dnviti-personal-org/esp8266-d1mini-button/hardware/enclosure/full-iso-nolid.png

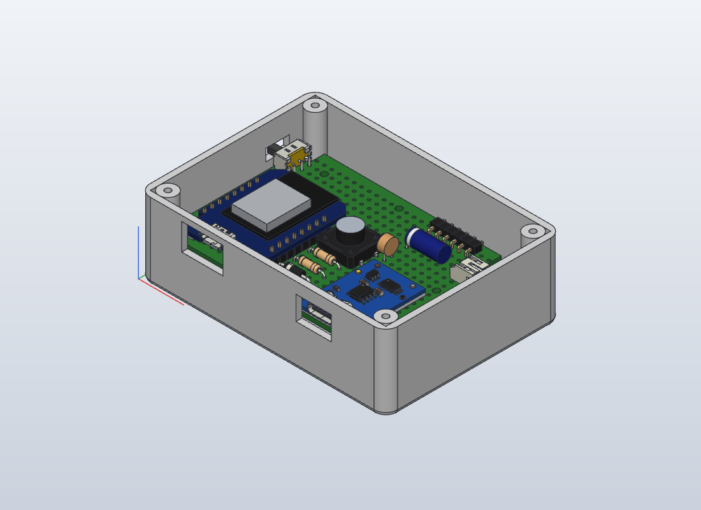
hardware/enclosure/full-iso-nolid.png
