dnviti-personal-org/esp8266-d1mini-button/hardware/enclosure/electronics-iso.png

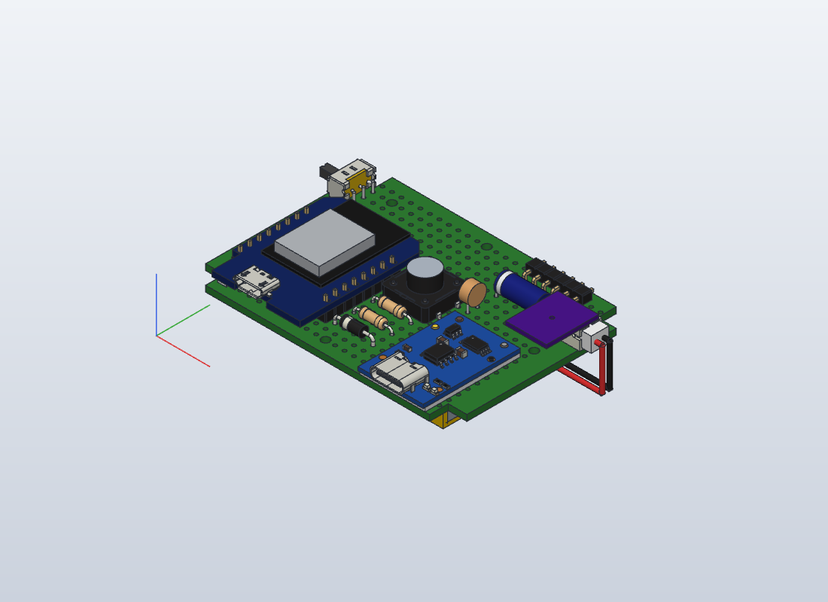
hardware/enclosure/electronics-iso.png
