dnviti-personal-org/esp8266-d1mini-button/hardware/enclosure/README.md

# Enclosure (rev. C, realistic electronics from `layout.json`) — 3D-printed box for the ESP8266 D1 mini button

Parametric CAD built with **SolidCraft** (`solidcraft-cli`) from the JSON scripts
in this folder. Box, lid and key cap follow `../DESIGN.md` §6 (LiPo under the
board, charging USB-C, INMP441 microphone, big domed key cap) except for the
deviations listed below. Since **rev. C** the electronics model is generated
from `../layout/layout.json` (the single source of truth for every lead
position and every wire, produced by `../layout/gen_layout.py`): perfboard at
cavity offset (2.46, 1.73), 5 × 5 notches, mounting holes on grid holes L1,
L18, C17, X11, every lead in its named hole, all 25 solder-side wires
modelled, SW2 on the x = 0 wall, M1 glued flat.

## Files

| File | What it is |
|---|---|
| `base.script.json` → `base.solidcraft`, `base.stl`, `base.step` | Box: 2 mm floor + 2 mm walls around the 80 × 56 × 24 mm cavity, 4 PCB standoffs Ø5 × 11 at cavity (36.19, 5.14) (36.19, 48.32) (13.33, 45.78) (66.67, 30.54) (= perfboard grid holes L1, L18, C17, X11 + offset), 4 lid screw bosses Ø6, programming micro-USB slot 14 × 9 at cavity x 19.68 and charging USB-C slot 12 × 8 at x 57.5, z 16.2 (y = 0 wall; micro-USB z 17.7), slide-switch slot 8 (y) × 4 (z) through the **x = 0 wall** at cavity y 43.24 (hole A16), z 14.75 (= centre of the SW2 knob with the switch body resting on the board top), 4 rubber-foot recesses Ø8 × 0.8. Outer 84 × 60 × 26 mm. |
| `lid.script.json` → `lid.solidcraft`, `lid.stl`, `lid.step` | 84 × 60 × 2 mm plate with the Ø52.6 key-cap hole, 4 countersunk Ø2.8 screw holes, 1 mm alignment lips on the short sides (the right one in two segments), INMP441 microphone pocket 11.5 × 15 × 1.2 mm on the underside with a Ø2 sound hole, and the 10 × 2.5 charge-LED window at cavity (62, 4.5). Bounding box 84 × 60 × 3.5 mm (2 plate + 1.5 lips). |
| `plunger.script.json` → `plunger.solidcraft`, `plunger.stl`, `plunger.step` | Key cap: Ø52 domed cap, Ø55 retaining flange, Ø8 stem. Bounding box Ø55 × 13.8 mm. Unchanged from rev. A. |
| `assembly.script.json` → `assembly.solidcraft` | The three printed parts, exploded by the `explode` parameter (14 mm; 0 = assembled). |
| `electronics.script.json` → `electronics.solidcraft`, `electronics.step` (the .stl is not committed: 16 MB, regenerate with the script) | **Realistic** electronics generated by `gen_electronics.py` from `../layout/layout.json`: real STEP models from `models/` (see `models/SOURCES.md`) inserted with `file.insert_step`, the rest built in the script (perfboard with its 24 × 18 hole grid, notches and mounting holes; TP4056 module foam/PCB/pads; C3, C4; SW2 bent pins; INMP441 breakout; LiPo pouch, kapton band, leads and plug; all wires `W<n>_<net>` and the JP1 bridge `W2_RST`). Bodies are named by reference designator. World = cavity + 2. |
| `full-assembly.script.json` → `full-assembly.solidcraft`, `full-assembly.step` (.stl not committed, 18 MB) | Base + electronics + lid + key cap + M2, assembled (`explode` = 0). |
| `electronics-nobattery.script.json` | `electronics.script.json` with the BT1 bodies removed (for `electronics-bottom.png`). |
| `full-assembly-exploded.script.json`, `full-assembly-nolid.script.json`, `full-assembly-section.script.json`, `full-assembly-check.script.json` | Variants of the full assembly: `explode` = 14; lid/cap/M2 removed (`solid.remove`, used for the "nolid" renders — a `show_lid` parameter is not possible because a SolidCraft parameter cannot drive visibility); everything in front of world y = 29 removed or cut (1 mm beside the key-cap centre, along X — the revolve seam at y = 30 itself cannot be cut) for the section render; `inspect.interference` on all bodies. |
| `base-iso.png`, `base-top.png`, `base-bottom.png`, `lid-iso.png`, `lid-bottom.png`, `lid-underside.png` (mic pocket + lips), `plunger-iso.png`, `assembly-iso.png` | Snapshots of the printed parts. |
| `electronics-iso.png`, `electronics-top.png` (component side, straight down), `electronics-bottom.png` (solder side, looking up, battery hidden so all wires show; `electronics-bottom-with-battery.png` with the LiPo), `full-top-nolid.png`, `full-iso-nolid.png`, `full-iso.png`, `full-exploded.png`, `full-section.png` | Populated board alone; full assembly: top and iso without lid/cap, closed, exploded, and sectioned 1 mm beside the key-cap centre. |
| `models/*.step`, `models/SOURCES.md` | The STEP models used, with their origin and licence (KiCad packages3D CC-BY-SA 4.0 + KiCad library exception; Technariumas shd18badge Apache-2.0). |

The base and lid are modelled with the **outer bottom-left corner at the
origin**; cavity coordinates from DESIGN.md are world coordinates + (2, 2, 2).
The lid's z = 0 is its underside (lips go to negative z). The key cap is
centred on the Z axis with z = 0 at the flange underside.

## Rebuilding

From WSL (Windows paths because the CLI is a Windows executable; copy the
scripts to a Windows folder first):

```
SC="/mnt/c/Program Files/SolidCraft/solidcraft-cli.exe"
WD='C:\Users\<you>\esp-button-cad\enclosure'
"$SC" run "$WD\base.script.json"    --out "$WD\base.stl"    --out "$WD\base.step"    --save "$WD\base.solidcraft"
"$SC" run "$WD\lid.script.json"     --out "$WD\lid.stl"     --out "$WD\lid.step"     --save "$WD\lid.solidcraft"
"$SC" run "$WD\plunger.script.json" --out "$WD\plunger.stl" --out "$WD\plunger.step" --save "$WD\plunger.solidcraft"
"$SC" run "$WD\assembly.script.json" --save "$WD\assembly.solidcraft"
"$SC" snapshot "$WD\base.script.json" --out "$WD\base-iso.png" --view iso --width 1000 --height 750 --no-grid
"$SC" snapshot "$WD\lid.script.json"  --out "$WD\lid-underside.png" --camera '{"target":[42,30,0],"yaw":0.6,"pitch":-0.9,"distance":230}' --no-grid
```

`electronics.script.json` and the `full-assembly*.script.json` variants are
written by `gen_electronics.py` (run it in the staging folder that holds
`lid/base/plunger.script.json`, with the path of `../layout/layout.json` as its
argument; it expects the STEP models at `C:/Users/daniele/esp-button-cad/models/`
— edit `M` at the top for another machine). Do not edit those scripts by hand.

`solidcraft-cli eval <script>` prints bounding box, volume and mass of each body.
`assembly.script.json` is the lid script, then the base parameters, the lid
move, the key-cap script, the cap move, and finally the base script
(parameters deduplicated by name); regenerate it the same way after editing a
part script.

### Parameters

`base.script.json` and `lid.script.json` start with `parameters.add` commands
(`wall`, `floor_t`, `cav_x/y/z`, `r_vert`, `r_edge`, `boss_d`, `standoff_d/h`,
`usb_*` (programming), `usbc_*` (charging), `sw_*`, `foot_*`, `lip_*`,
`cap_hole_d`, `cap_x/y`, `mic_x/y`, `mic_hole_d`, `mic_pocket_w/l/d`, `led_*`). All box/cylinder sizes and
positions are expressions of these. Limitation of the SolidCraft script
format: fillet edge picks and `solid.hole` positions are numeric 3D points
(boss/standoff/mic centres on the top faces), so after changing `cav_x`,
`cav_y`, `cav_z`, `wall`, `standoff_h` or `mic_x/y` also update those points.
The key cap is a single revolved profile with numeric coordinates.

## Key cap numbers (z from the flange underside, mm)

| Feature | Ø | z range | Note |
|---|---|---|---|
| Stem | 8 | −2.3 … 0 | tip rests 0.3 mm above the tactile-switch actuator |
| Flange | 55 | 0 … 1.5 | bears on the lid underside, r 0.5 edge fillet |
| Rim | 52 | 1.5 … 7.5 | 2 mm inside the lid + 4 mm proud; 0.3 mm radial clearance in the Ø52.6 hole |
| Dome | 52 → 0 | 7.5 … 11.5 | spherical, R = 86.5 mm, rises 4 mm; r 2 fillet where it meets the rim |

Assembled (cavity z, inner floor = 0): lid underside 24, flange 22.5–24,
stem tip 20.2 (actuator top 19.9 + 0.3 play), cap top 34 = 8 mm above the lid
top (26). Travel ≈ 0.5 mm, limited by the switch. The LiPo (8 mm) lies under
the perfboard (underside at 11 mm, solder pins down to 9.5 mm).

## Printing

Material PETG or PLA, 0.2 mm layers, 3 perimeters, 15–20 % infill.

| Part | Orientation | Supports |
|---|---|---|
| Base | floor on the bed (as modelled) | None needed. The three wall slots are bridged through a 2 mm wall; the 12 mm USB bridge prints fine, enable supports only if your printer bridges badly. |
| Lid | **top face on the bed** (flip 180° in the slicer) | None: the lips point up, the mic pocket is a plain recess, the 90° countersinks become 45° overhangs. |
| Key cap | **dome up**, stem on the bed (as modelled) | Supports under the flange ring (2.3 mm tall, "on build plate only" is enough). Print in a bright colour (red/yellow). |

If the cap binds in the lid hole, sand the rim or raise `cap_hole_d` to 53.
The INMP441 board (11 × 14 × 1.6) sits in the 11.5 × 15 × 1.2 pocket and
protrudes 0.4 mm below the lid; nothing in the base is in the way there.

## Assembly

1. Tape the LiPo (40 × 30 × 8) to the inner floor, centred between the standoffs (cavity (40, 28)), leads toward the charger.
2. Screw the perfboard to the 4 standoffs (M2 × 8 mm self-tapping, Ø1.6 pilots at perfboard holes (34, 3) (34, 47) (6, 40) (64, 21); the board sits at cavity offset (5, 1.5), 11 mm above the floor, with its four corners notched 4 × 4 mm to clear the lid bosses).
3. Route the micro-USB and USB-C to their slots in the y = 0 wall and the slide switch to the slot in the x = 80 wall (micro-USB face ≈ 0.5 mm and USB-C face ≈ 0.75 mm inside the wall); check the tactile switch is centred under cavity (40, 28).
4. Glue (drop of CA or foam tape) the INMP441 breakout into the pocket on the lid underside, port over the Ø2 sound hole, and run its 6 wires (SCK WS SD L/R VDD GND) to J2 on the perfboard.
5. Drop the key cap into the lid **from the inside** (stem down) — the Ø55 flange retains it.
6. Lower the lid onto the base, lips first (they align the lid on the short walls), and fix with 4 × M2.5 × 10 mm self-tapping screws into the Ø2.0 boss pilots (countersunk from the top). The TP4056 charge LEDs are visible through the 6 × 3 window near the USB-C corner.
7. Stick Ø8 rubber feet into the four recesses under the floor.

## Deviations from DESIGN.md §6

- **Charge-LED window centred at cavity (62, 4.5) instead of (57.5, 4.5)**
  (10 × 2.5 as specified): at x = 57.5 its NE corner (52.5, 5.75) is 25.5 mm
  from the key-cap centre, 2 mm under the Ø55 flange; moving it to x = 62
  (nearest corner (57, 5.75), r = 28.0) gives the required 0.5 mm. It is far
  from the short-side lips. In the rev. C model the two TP4056 LEDs are placed beside the
  USB-C at cavity (63.3, 5.2) and (65.3, 5.2), i.e. under the window; check
  the real module (LED positions vary between 03962A batches). `led_x`/`led_y` are parameters.
- **Mic pocket 11.5 mm wide instead of 12**, still centred at cavity (74, 28):
  spans cavity x 68.25–79.75, i.e. 0.75 mm clear of the Ø55 key-cap flange
  (edge at 67.5) and 0.25 mm from the wall; a 12 mm pocket would end exactly
  at the wall. The INMP441 PCB (11 × 14) has 0.25/0.5 mm play. The right-side
  alignment lip is omitted over the pocket's y range (+0.5 mm each side) so
  the board, which protrudes 0.4 mm below the lid, can sit there; the lip is
  two segments (y 8.5–22 and 38–51.5 world).
- **Stem 2.3 mm** as in §6 (tip at 20.2 = 19.9 + 0.3).
- r 1.5 fillet applied to the base bottom edge loop and the lid top edge loop.
- **Alignment lip** (not in DESIGN.md): only along the two short walls, 1 mm
  wide, 1.5 mm tall, 0.2 mm clearance; the Ø55 flange would hit a lip on the
  long walls.
- Slide-switch slot cut starts 0.5 mm inside the wall (no visible effect; avoids
  a sliver boolean with the corner boss).
- Standoff pilot holes are Ø1.6 × 6 mm deep (not through the 11 mm standoff);
  boss pilot holes Ø2.0 × 9 mm deep (10 mm screws through the 2 mm lid).
- Added for comfort/printability: r 2 fillet on the cap's rim/dome edge, r 0.5
  on the flange edge.
- Masses from SolidCraft (PETG 1.29 g/cm³, solid): base ≈ 34 g, lid ≈ 6.9 g,
  key cap ≈ 25 g (solid cap; use infill).

## Electronics model (rev. C) and clearances

`electronics.script.json` is generated from `../layout/layout.json` by
`gen_electronics.py`. Parameters: `pcb_x0`/`pcb_y0` = 4.46/3.73 mm (perfboard
origin, world = cavity offset (2.46, 1.73) + wall), `pcb_z0` = 13 mm (board
underside = floor 2 + standoff 11), `pcb_t` = 1.6, `pcb_top` = 14.6 mm (cavity
12.6), `hdr_h`, `wire_z` = `pcb_z0 − 0.6` (axis of the solder-side wires,
cavity 10.4). Every placement is an expression of these except the D1 mini
group: its STEP is Y-up and SolidCraft applies *expression* translations to a
Y-up import in the component's own frame, so that one `solid.move` uses plain
numbers (34.48, 4.01, 17.14 = `pcb_x0 + 30.02`, `pcb_y0 + 0.28`, `pcb_top + 2.54`).
Hole names below are the `layout.json` grid names (A1 = perfboard (5.79, 3.41),
2.54 pitch, 24 columns × 18 rows).

**What is imported vs built, and how each part sits in its holes**

| Ref | Model | Placement / notes |
|---|---|---|
| PCB1 | built | 70 × 50 × 1.6, **5 × 5** corner notches, Ø2.2 mounting holes on grid holes L1, L18, C17, X11, 24 × 18 grid of Ø1.0 holes cut as one sketch pattern (`c1`). |
| U1 | `WEMOS_D1_mini_Technariumas.step` (real outline, ESP-12 shield, CH340, reset) + `USB_Micro-B_Molex_47346-0001.step` + 2 × `PinHeader_1x08_P2.54mm_Vertical.step` | Header pins in **A3..A10 / J3..J10**, module outline perfboard x 4.42–30.02, y 0.28–34.48 (matches `parts[U1].body`). **Mounting rule**: long (6 mm) header side down through the perfboard, trimmed flush after soldering (modelled as a 1 mm stub); the 2.54 mm plastic is the spacer; short side through the D1 mini. The STEP's own micro-USB (wrong side) is removed and the Molex micro-B put on the shield side 1 mm proud of the module edge: **face at cavity y 1.01**, connector centre cavity x 19.23 (the STEP's USB is 0.45 mm off the module centre; the slot is centred on the module, 19.68, and is 14 wide so 2.55 mm remain on the near side), z 16.6–19.6 inside the 13.2–22.2 slot. Appearance: PCB LOLIN dark blue `#15265f`, shield metallic grey (`pbr`). Module PCB is 1.5 mm thick in this STEP (real 1.0). |
| SW1 | `SW_PUSH-12mm_Wuerth-430476085716.step`, actuator cut to 7.3 mm (B3F-4000) | Pins in **K9, P9, K11, P11**, centre perfboard (37.54, 26.27) = cavity (40.0, 28.0) = key-cap axis. The STEP's pins are 12.5 mm apart, the holes 12.7: each pin is 0.1 mm off its hole centre (as the layout note says). Actuator top cavity z 19.9; the Würth 8.5 mm variant would need 1.2 mm more cap stem. |
| D2, R2, R3 | KiCad `D_DO-41…`, `R_Axial_DIN0207…P10.16mm` | Pin 1 in **K3 / K5 / K7**, pin 2 in O3 / O5 / O7 (10.16 mm = 4 columns, exact). D2 band (pin 1 of the KiCad model) at K3. |
| C3 | built: Ø5 × 2.5 disc 1.5 mm above the board, two Ø0.5 leads | **Q11 / Q12** (2.54 mm pitch; the only KiCad disc model at hand is 5.00 mm pitch). |
| C4 | built: Ø5 × 11 can lying along +x, axis 3 mm above the board, grey stripe at the − end, two Ø0.5 leads bent 90° | Leads in **Q14 (−) / Q15 (+)**, can perfboard x 47–58 (`parts[C4].body`). A real Ø5 × 11 part has 2.0 mm lead pitch: the 0.27 mm fan-out to the 2.54 holes is not modelled (leads drawn at the hole centres). |
| J2 | `PinHeader_1x06_P2.54mm_Horizontal.step` rotated 90° | THT pins in **Q17..V17**, bent pins toward row 18, trimmed at perfboard y 49.5 (board edge 50). The KiCad model puts the 2.54 mm plastic on the bent-pin side of the THT row (y 43.7–46.6) — 1 mm further toward the edge than `parts[J2].body`. |
| J1 | `JST_PH_S2B-PH-K_1x02_P2.00mm_Horizontal.step` rotated 90° | 2.0 mm pins centred between **X14 / X15** (each pin 0.27 mm from its hole centre, spread when soldering). Mouth toward +x at perfboard x 70.46 = **cavity 72.92** (0.46 mm past the board edge; the layout box ends at 70.0). |
| SW2 | `SW_Slide_SPDT_Straight_CK_OS102011MS2Q.step` as stand-in for the SS12D00G4 (no KiCad model of the SS12D00) | Laid on its side at the left board edge: pin-exit face at perfboard x 4.8, lever toward the x = 0 wall, body resting on the board top. The STEP's straight 2.0 mm-pitch pins are removed and replaced by built Ø0.6 pins bent 90° at 1 mm from the body face into **A15, A16, A17** (0.54 mm fan-out). Body 8.6 (y) × 4.3 (z) × 4.7 (x): perfboard y 37.21–45.81 as in `parts[SW2].body`, but x **0.1–4.8** (the C&K body is 4.7 mm tall, the layout assumes 3.7). Knob 2 mm thick, **centre cavity z 14.75** (13.75–15.75), 4 mm lever, tip at perfboard x −3.9 = **cavity x −1.44** (inside the 2 mm wall, 0.56 mm short of the outer face; the layout estimate was −0.44). The base slot (y 43.24, z 14.75, 8 × 4) gives 1.0 mm above and below the knob and 1.2 mm each side. |
| M1 | built: 1 mm foam 17.5 × 25.5, PCB 17.5 × 26 × 1 (blue), Ø1.5 pads at `m1_pads` (+ unused IN±); inserted: `USB_C_Receptacle_GCT_USB4125…`, `SOIC-8`, `SOT-23-6`, `TSSOP-8`, 2 × `LED_0603`, 3 × `R_0603`, `C_0603`, 2 × `C_0805` | Glued flat, **no header pins**: PCB perfboard x 46.29–63.79, y −0.5–25.5 (`parts[M1].body`, 0.5 mm over the USB edge), top 2.0 mm above the perfboard. USB-C centred on x 55.04 = cavity 57.5; its shell is 1 mm proud of the module PCB: **face at cavity y 0.23**, shell z **14.6–17.86** (centre 16.23) in the 12.2–20.2 slot (`usbc_z` = 16.2, rev. C): 2.4 mm below, 2.3 mm above, 1.5 mm each side. LEDs at perfboard (60.8, 3.5) and (62.8, 3.5) = cavity (63.3, 5.2), (65.3, 5.2), under the lid window. The module's own component placement is illustrative. |
| M2 | built: PCB 11 × 14 × 1, INMP441 lid, Ø1 port, 6 pads; inserted `C_0603` | Unchanged: in the lid pocket at cavity (74, 28), component side down. The right-hand gap (board edge cavity 72.46 → wall 80) below it holds only J1's mouth, the plug and the leads. |
| Wires | built from `wires[]`: insulated = Ø1.1 straight cylinder lying against the underside (axis cavity z 10.4) between the two holes, bare link = Ø0.6; a Ø0.64 × 2.7 stub into each hole and a Ø1.8 × 0.6 solder blob under it; the five `M1:` wires start at the pad on the module top with a vertical run down through module and board (as specified), then along the underside | Named `W<n>_<net>`, colours from `wires[].colour` (turquoise #30D5C8, pink #FF69B4, violet #8A2BE2, white, black, red, yellow, brown, grey, green, blue; bare silver). `W2_RST` = the JP1 solder bridge, a 1.6 × 4.1 × 0.6 blob between A10 and A11 on the solder side. Lowest wire surface cavity z 9.85 (stubs 9.7). |
| BT1 | built | Pouch 40 × 30 × 8 (r 1) at cavity (40, 28) on the floor, 0.2 mm kapton band on the +x end, Ø1.2 red/black leads along +x under the board at cavity z 4 (y 38.4 / 40.4 = J1's pin rows), up at cavity x 77.0 (outer surface 77.6, **2.4 mm from the wall**), into the PHR-2 housing 6 × 4.75 × 4 inserted 3.5 mm into J1 (housing cavity x 69.4–75.4). |

**Measured clearances (real geometry, `full-assembly-eval.json` bounding boxes).**
z is cavity z (world z − 2). Reference surface: key-cap flange underside at
22.5 mm (rest) / 22.0 mm (pressed) for anything inside the Ø55 flange
(r < 27.5 mm from the cap axis at cavity (40, 28)); lid underside at 24 mm
otherwise. Anything under 1 mm is flagged.

| Part | Top z | Ref | Clearance rest / pressed | Status |
|---|---|---|---|---|
| U1 ESP-12 shield | 19.94 | flange | 2.56 / 2.06 | OK |
| U1 micro-USB (face cavity y 1.01) | 19.58 | flange | 2.92 / 2.42 | OK — z 16.6–19.6 in slot 13.2–22.2 |
| U1 headers | 18.14 | flange | 4.36 / 3.86 | OK |
| SW1 actuator (7.3 mm) | 19.90 | flange | 2.60 / 2.10 | OK — 0.3 mm play to the cap stem tip (20.2) |
| C3 | 19.10 | flange | 3.40 / 2.90 | OK |
| C4 | 18.13 | flange | 4.37 / 3.87 | OK |
| M1 USB-C shell (face cavity y 0.23) | 17.86 | flange | 4.64 / 4.14 | OK — z 14.6–17.86 centred in slot 12.2–20.2 (2.4 below / 2.3 above) |
| M1 ICs / passives | 16.35 | flange | 6.15 / 5.65 | OK |
| M1 PCB (foam 12.6–13.6) | 14.60 | flange | 7.90 / 7.40 | OK |
| J1 housing | 17.45 | flange | 5.05 / 4.55 | OK |
| BT1 plug | 17.10 | lid | 6.90 | OK |
| BT1 leads (outer surface cavity x 77.6) | 15.70 | flange | 6.80 / 6.30 | OK — 2.4 mm to the x = 80 wall |
| SW2 body (on its side, 4.3 thick) | 16.90 | lid | 7.10 | OK |
| SW2 knob z 13.75–15.75, slot 12.75–16.75 | 15.75 | lid | 8.25 | OK — **1.0 mm above and below the knob**, lever tip 0.56 mm inside the outer wall face |
| D2 | 15.81 | flange | 6.69 / 6.19 | OK |
| J2 (pins trimmed at y 49.5) | 15.14 | flange | 7.36 / 6.86 | OK |
| R2, R3 | 15.10 | flange | 7.40 / 6.90 | OK |
| PCB1 top | 12.60 | flange | 9.90 / 9.40 | OK |
| Wires under the board (lowest surface 9.85, stubs 9.7) vs BT1 tape top 8.2 | — | — | 1.5 (1.65 for the wire itself) | OK |
| Header / SW2 pin stubs, C3/C4 leads (down to z 10.0) vs BT1 | — | — | 1.8 | OK |
| SW1 legs (down to z 9.04) vs BT1 tape top 8.2 | — | — | 0.84 | **FLAG** (unchanged from B.3) — trim the SW1 legs flush or keep the pouch (band) out from under SW1 |
| BT1 pouch + band (z 0–8.2) vs PCB1 underside 11.0 | — | — | 2.8 | OK |
| M2 (lid pocket) vs cap flange edge / lid lips | — | lateral | 1.0 | OK (limit) |

**Interference check** (`full-assembly-check.script.json`, 132 body pairs
checked, 10 listed, `full-assembly-interference.json`): nothing against the
base, lid or key cap, and — now that every lead is in a hole — nothing against
PCB1. The 10 are modelling overlaps: 4 solder joints where a wire stub shares
a hole with a D1 mini header pin (A3, A8, J4, J8), 3 wires (`W6_BTN`,
`W16_CHRG`, `W18_VSW`) crossing the 1 mm stubs of J9/J10 — in reality those
stubs are trimmed flush and the wire passes over the joint — and 3 where the
`M1:` wires run down through the module/perfboard as specified.

**What differs from `layout.json` / DESIGN.md** (nothing was moved silently):
SW2 body 4.7 mm along x (C&K STEP) instead of 3.7, lever tip at cavity x
−1.44 instead of −0.44; J1 mouth 0.46 mm past the board edge; J2 plastic 1 mm
closer to the board edge than the layout box; SW1 pins 0.1 mm, J1 pins
0.27 mm, C4 leads 0.27 mm off their hole centres (lead-pitch vs 2.54 grid, all
within the Ø1.0 holes except J1's which need the usual spread); D1 mini
micro-USB 0.45 mm off the module centre.
