dnviti-personal-org/esp8266-d1mini-button/hardware/enclosure/base-iso.png

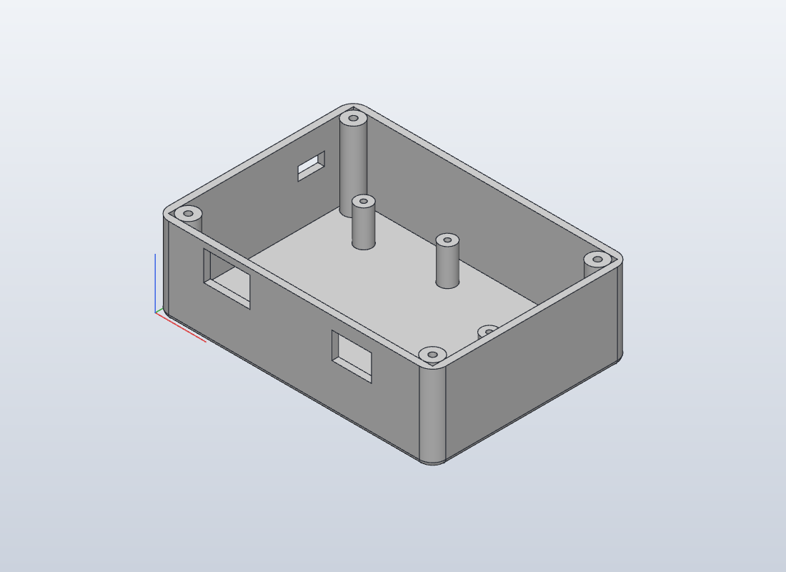
hardware/enclosure/base-iso.png
