dnviti-personal-org/esp8266-d1mini-button/hardware/enclosure/base-top.png

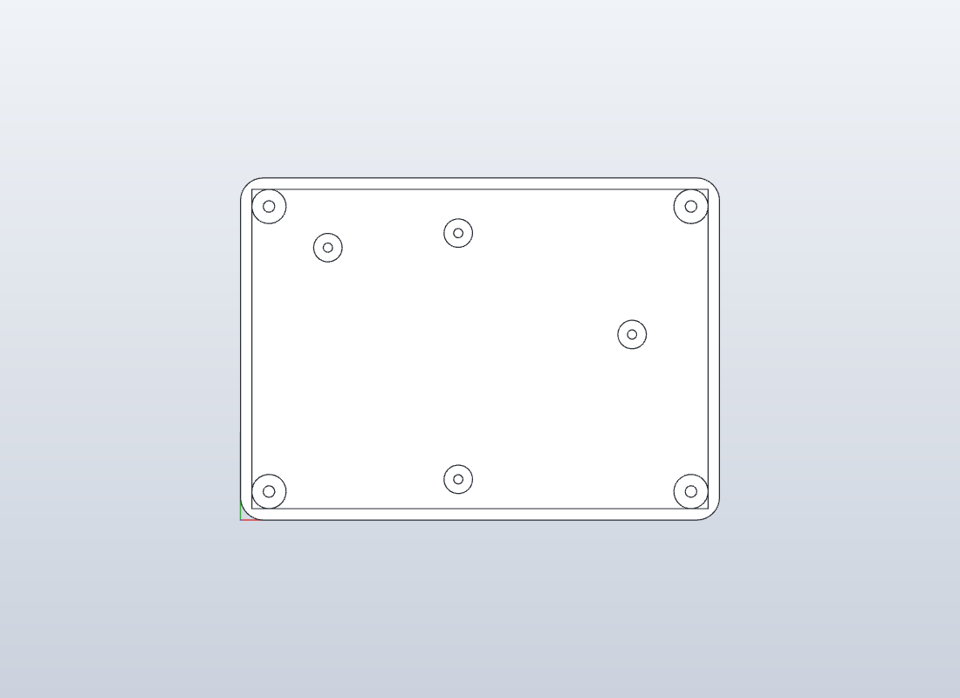
hardware/enclosure/base-top.png
