dnviti-personal-org/esp8266-d1mini-button/hardware/enclosure/electronics-bottom-with-battery.png

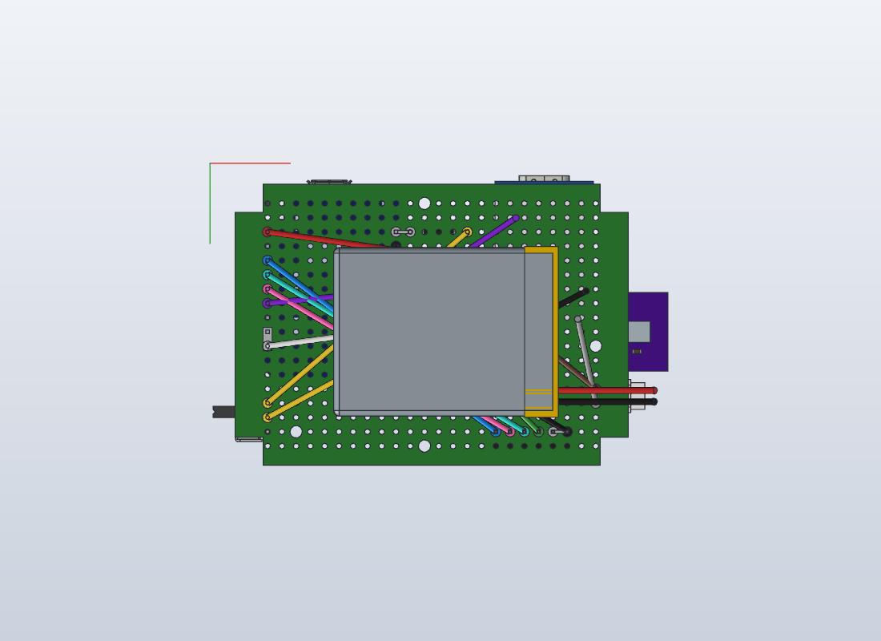
hardware/enclosure/electronics-bottom-with-battery.png
