dnviti-personal-org/esp8266-d1mini-button/hardware/enclosure/electronics-top.png

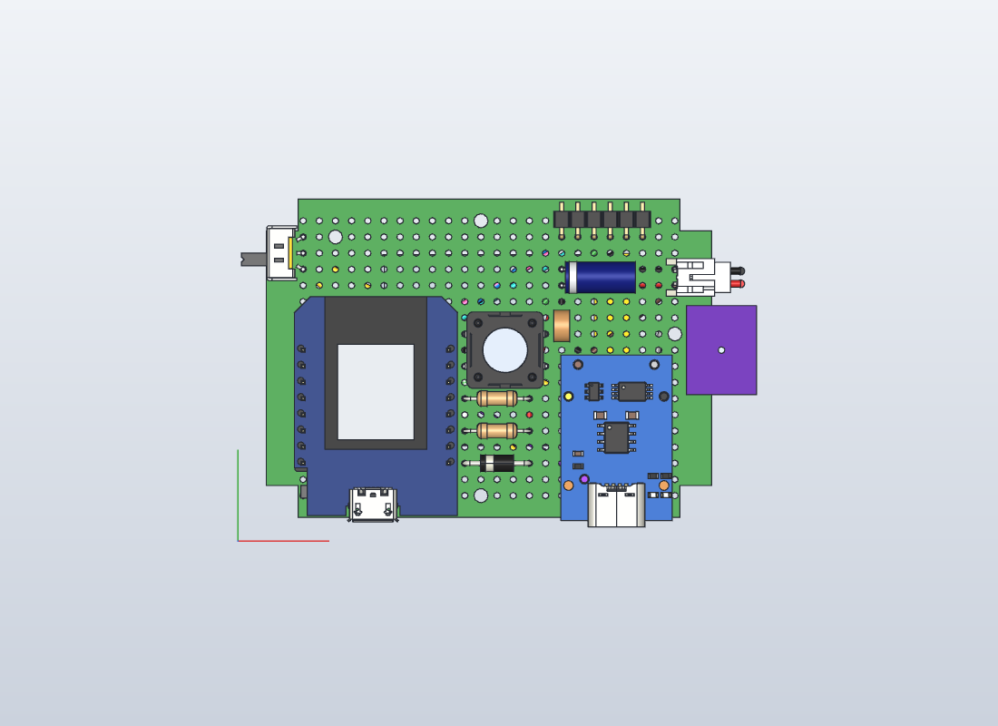
hardware/enclosure/electronics-top.png
