dnviti-personal-org/esp8266-d1mini-button/hardware/enclosure/full-exploded.png

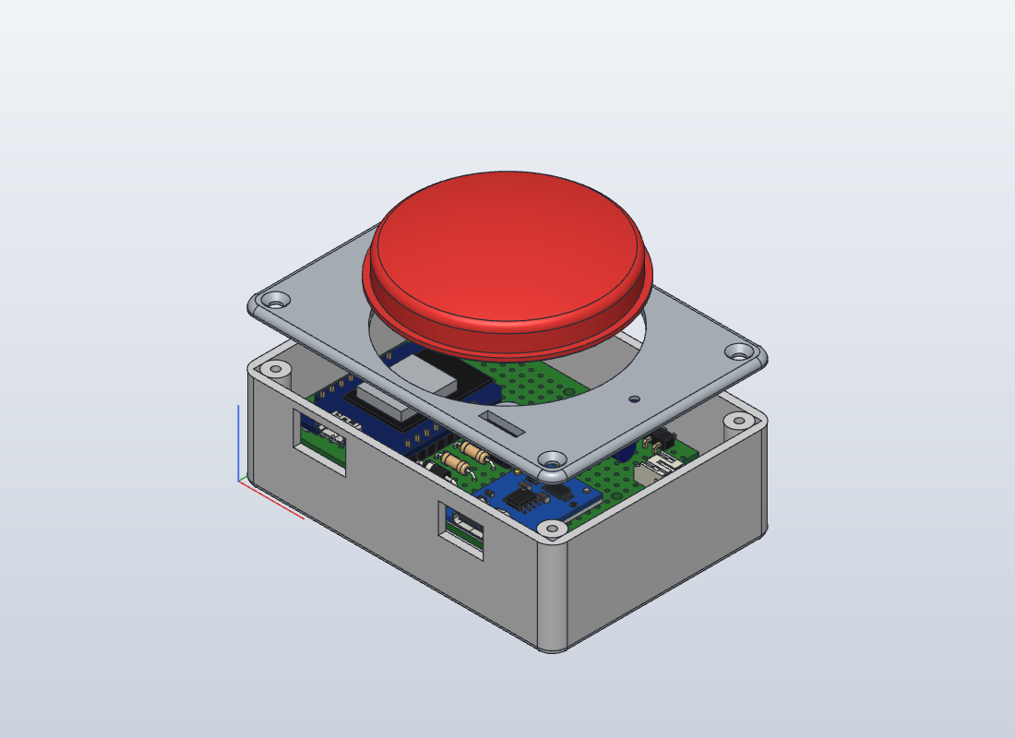
hardware/enclosure/full-exploded.png
