dnviti-personal-org/esp8266-d1mini-button/hardware/enclosure/full-section.png

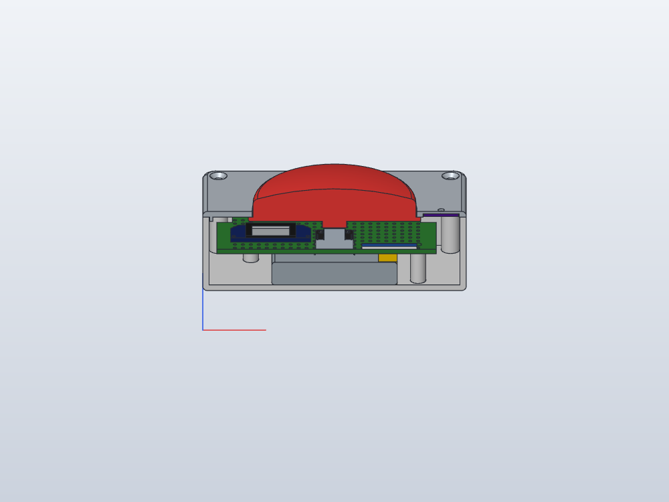
hardware/enclosure/full-section.png
