dnviti-personal-org/esp8266-d1mini-button/hardware/enclosure/lid-bottom.png

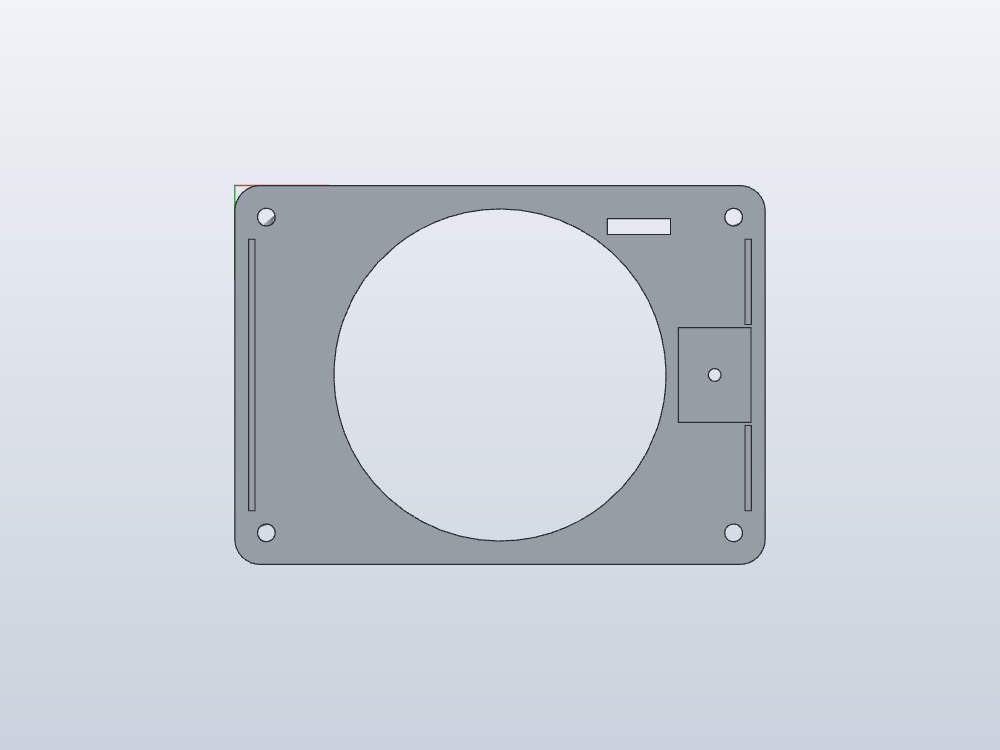
hardware/enclosure/lid-bottom.png
