dnviti-personal-org/esp8266-d1mini-button/hardware/enclosure/lid-iso.png

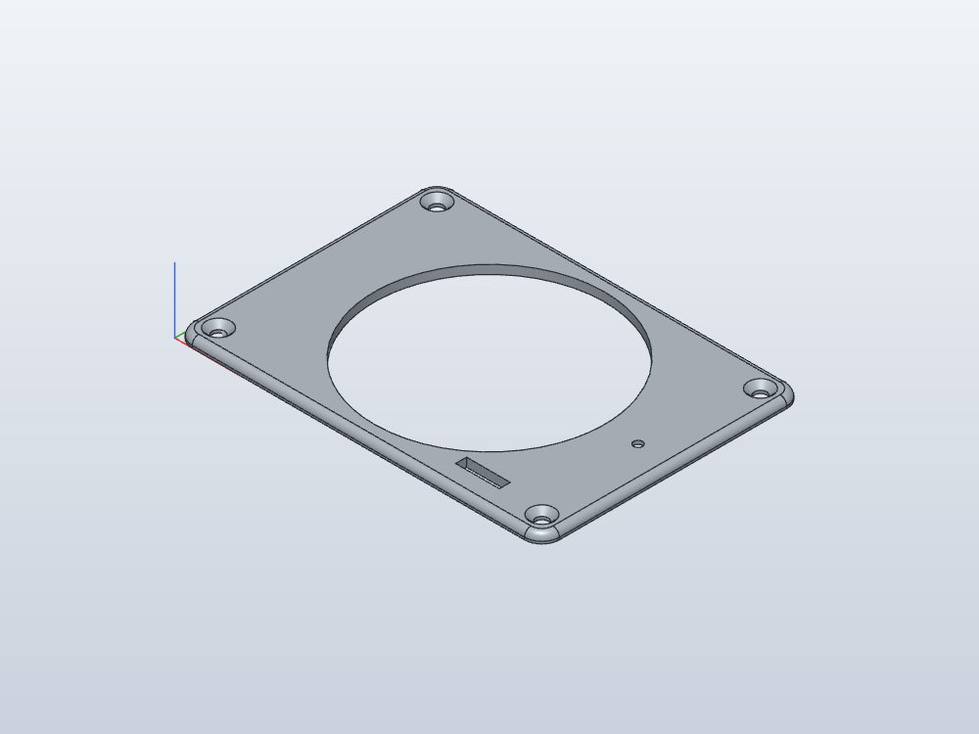
hardware/enclosure/lid-iso.png
