dnviti-personal-org/esp8266-d1mini-button/hardware/enclosure/lid-underside.png

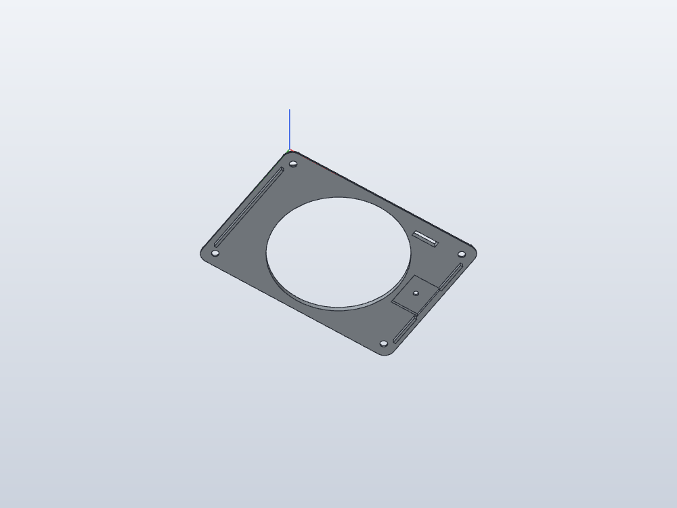
hardware/enclosure/lid-underside.png
