dnviti-personal-org/esp8266-d1mini-button/hardware/schematic/perfboard-layout.png

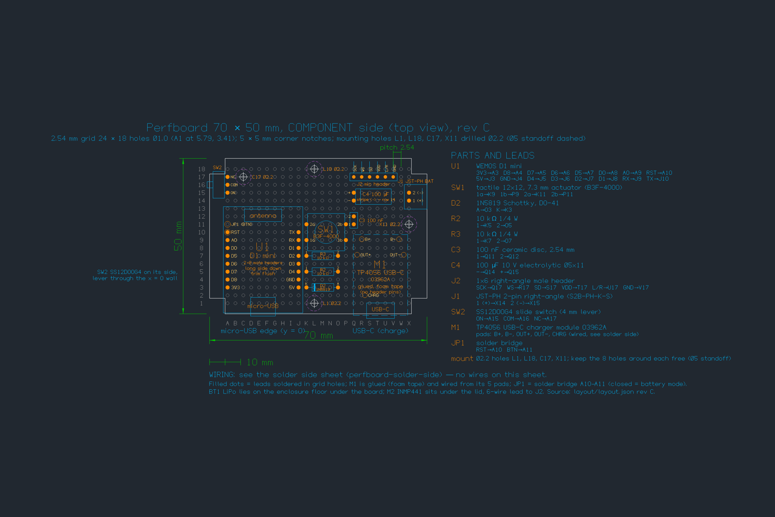
hardware/schematic/perfboard-layout.png
