dnviti-personal-org/esp8266-d1mini-button/hardware/schematic/schematic.png

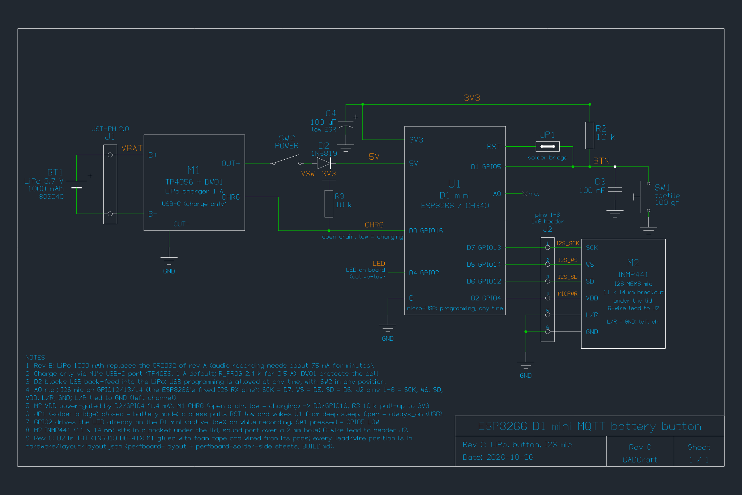
hardware/schematic/schematic.png
