dnviti-personal-org/esp8266-d1mini-button/hardware/enclosure/full-assembly.step

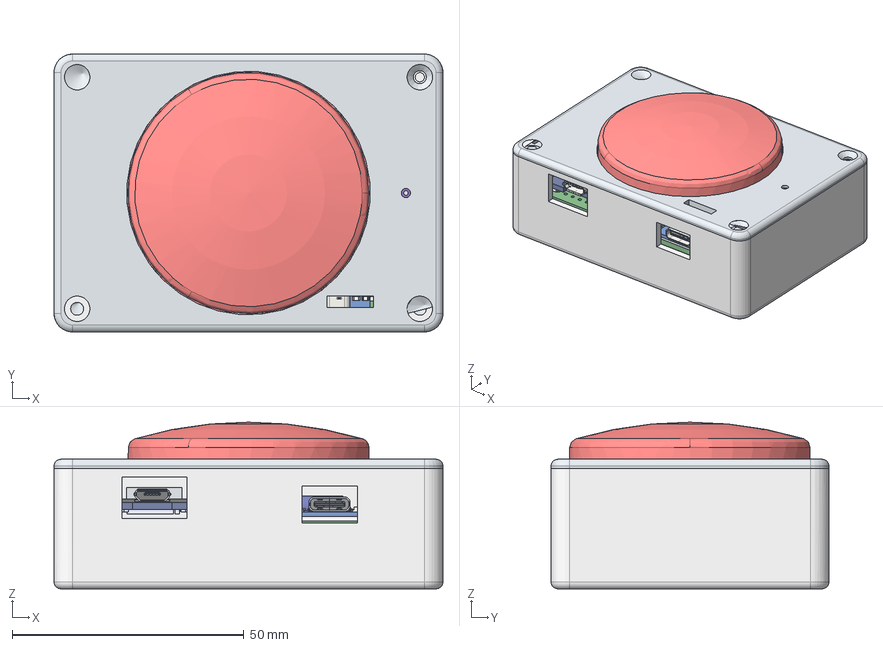
[picture p14: CAD file, 2026-10-26]
hardware/enclosure/full-assembly.step
84.0 x 60.0 x 36.0 mm
U1_H1
U1_H2
U1_USB
SW1
M1_USBC
M1_U1
M1_U2
M1_U3
M1_LED_red
M1_LED_blue
M1_R1
M1_R2
M1_R3
M1_C1
M1_C2
M1_C3
J2
J1
SW2
D2
R2
R3
M2_C1
