dnviti-personal-org/esp8266-d1mini-button/hardware/enclosure/assembly.step

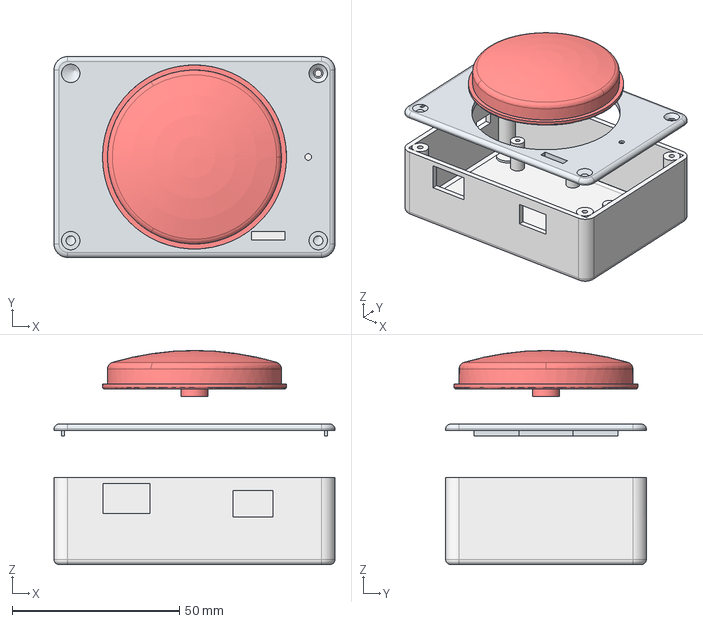
[picture p15: CAD file, 2026-10-26]
hardware/enclosure/assembly.step
84.0 x 60.0 x 64.0 mm
