dnviti-personal-org/esp8266-d1mini-button/hardware/enclosure/models/SW_PUSH-12mm_Wuerth-430476085716.step

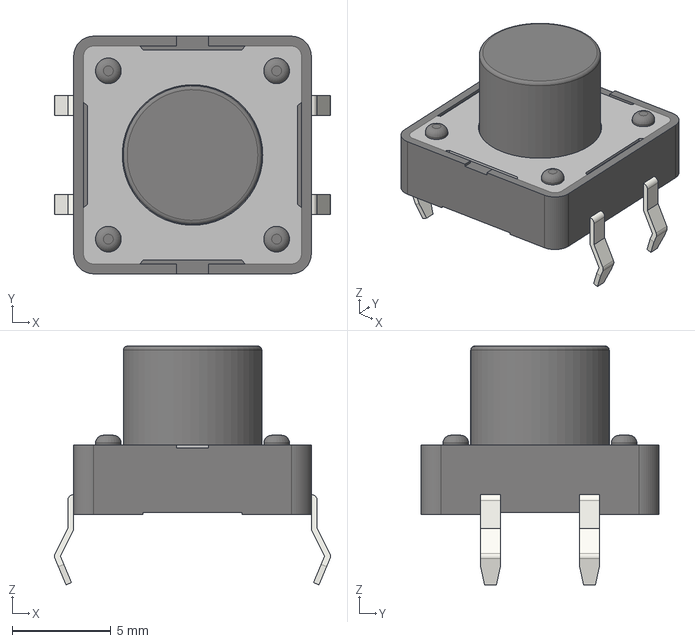
[picture p17: CAD file, 2026-10-26]
hardware/enclosure/models/SW_PUSH-12mm_Wuerth-430476085716.step
13.9 x 12.0 x 12.1 mm
