dnviti-personal-org/esp8266-d1mini-button/hardware/schematic/schematic.dxf

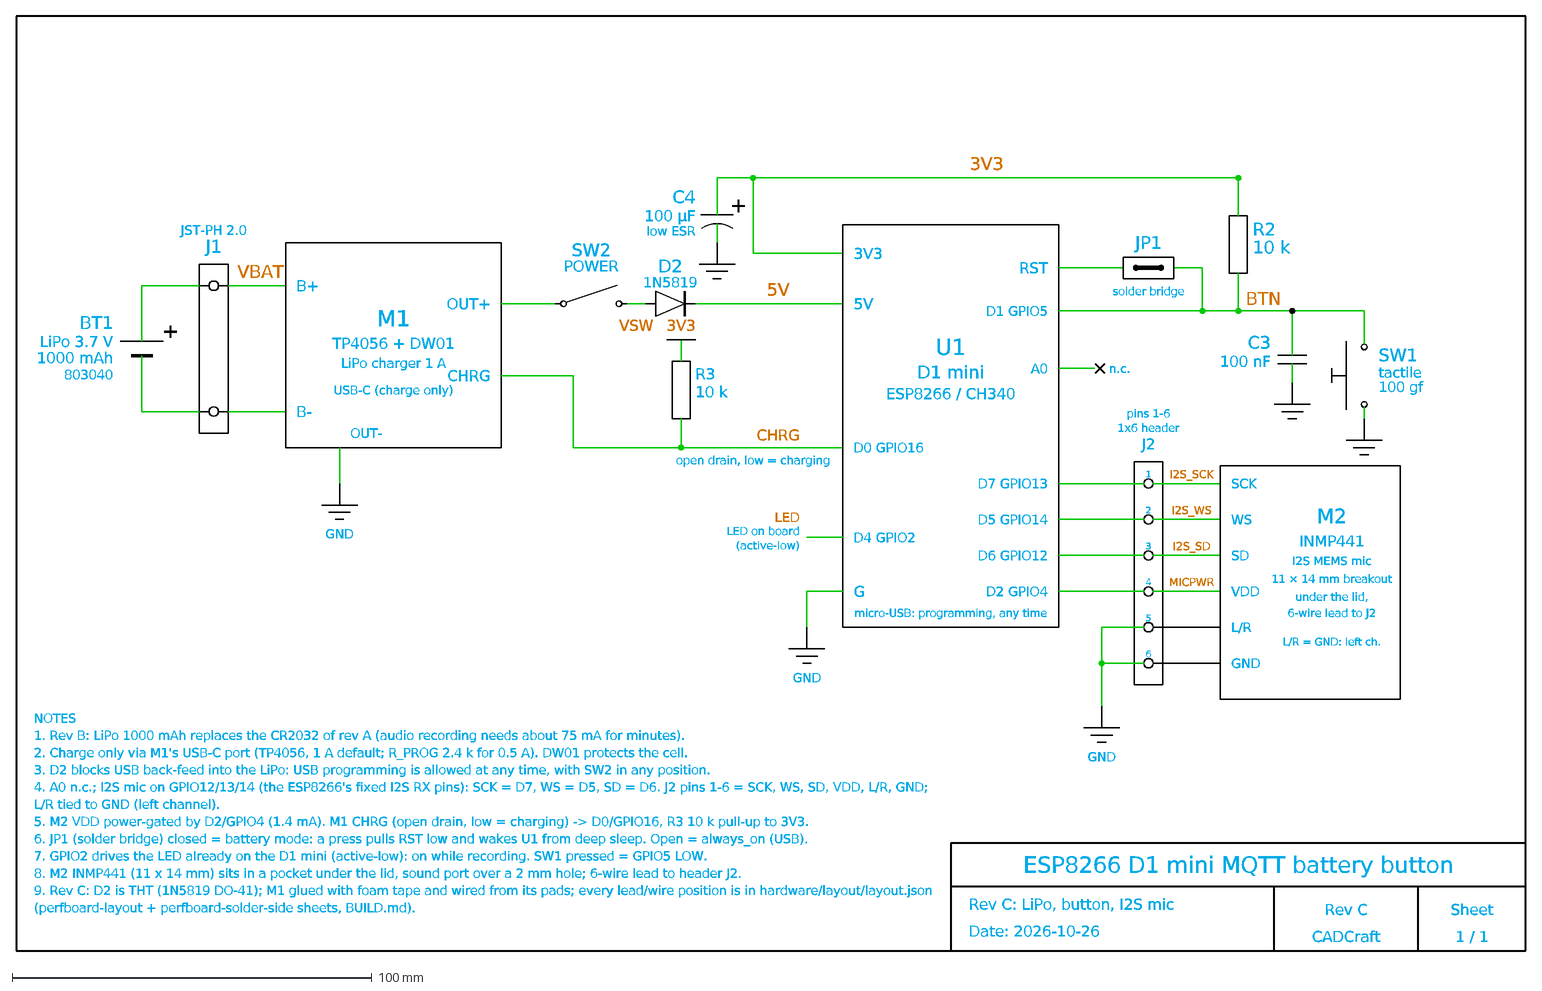
[picture p18: CAD file, 2026-10-26]
hardware/schematic/schematic.dxf
ESP8266 D1 mini MQTT battery button
Rev C: LiPo, button, I2S mic
Date: 2026-10-26
Rev C
CADCraft
Sheet
1 / 1
+
BT1
LiPo 3.7 V
1000 mAh
803040
J1
JST-PH 2.0
VBAT
B+
B-
OUT+
CHRG
OUT-
M1
TP4056 + DW01
LiPo charger 1 A
USB-C (charge only)
GND
SW2
POWER
D2
1N5819
VSW
5V
C4
100 µF
low ESR
3V3
R3
10 k
open drain, low = charging
D0 GPIO16
D4 GPIO2
G
RST
D1 GPIO5
A0
D2 GPIO4
D7 GPIO13
D5 GPIO14
D6 GPIO12
U1
D1 mini
ESP8266 / CH340
micro-USB: programming, any time
LED on board
(active-low)
LED
n.c.
JP1
solder bridge
BTN
R2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
