dnviti-personal-org/esp8266-d1mini-button/hardware/enclosure/base.step

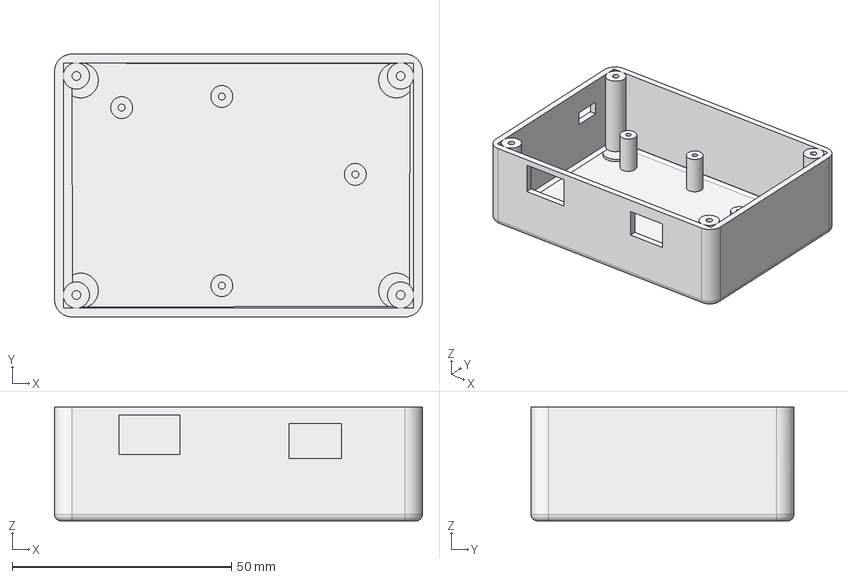
[picture p19: CAD file, 2026-10-26]
hardware/enclosure/base.step
84.0 x 60.0 x 26.0 mm
