dnviti-personal-org/esp8266-d1mini-button/hardware/schematic/perfboard-layout.dxf

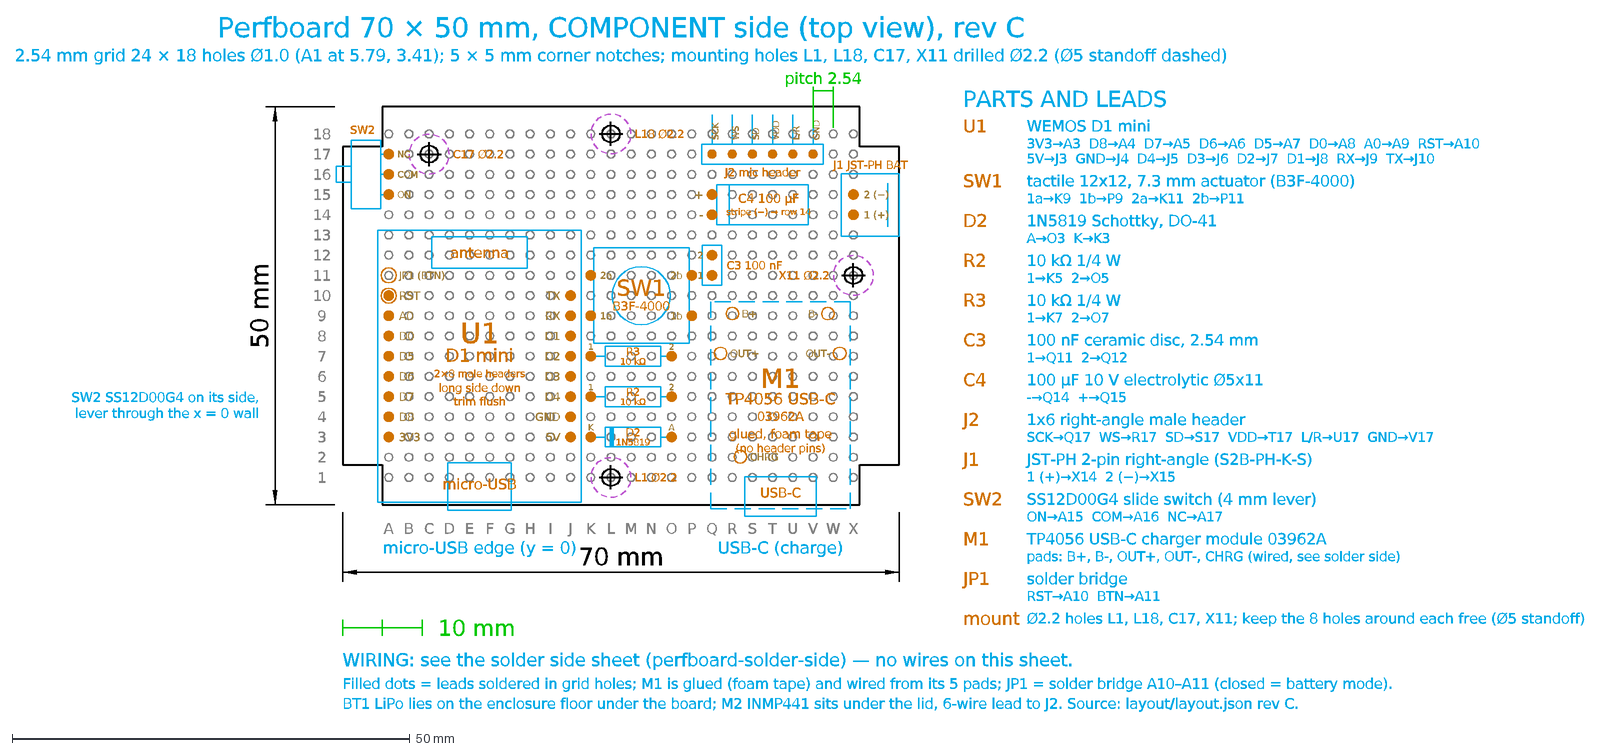
[picture p20: CAD file, 2026-10-26]
hardware/schematic/perfboard-layout.dxf
A
B
C
D
E
F
G
H
I
J
K
L
M
N
O
P
Q
R
S
T
U
V
W
X
1
2
3
4
5
6
7
8
9
10
11
12
13
14
15
16
17
18
L1 Ø2.2
L18 Ø2.2
C17 Ø2.2
X11 Ø2.2
micro-USB
antenna
U1
D1 mini
2×8 male headers
long side down
trim flush
3V3
D8
D7
D6
D5
D0
A0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
