dnviti-personal-org/esp8266-d1mini-button/hardware/schematic/perfboard-solder-side.dxf

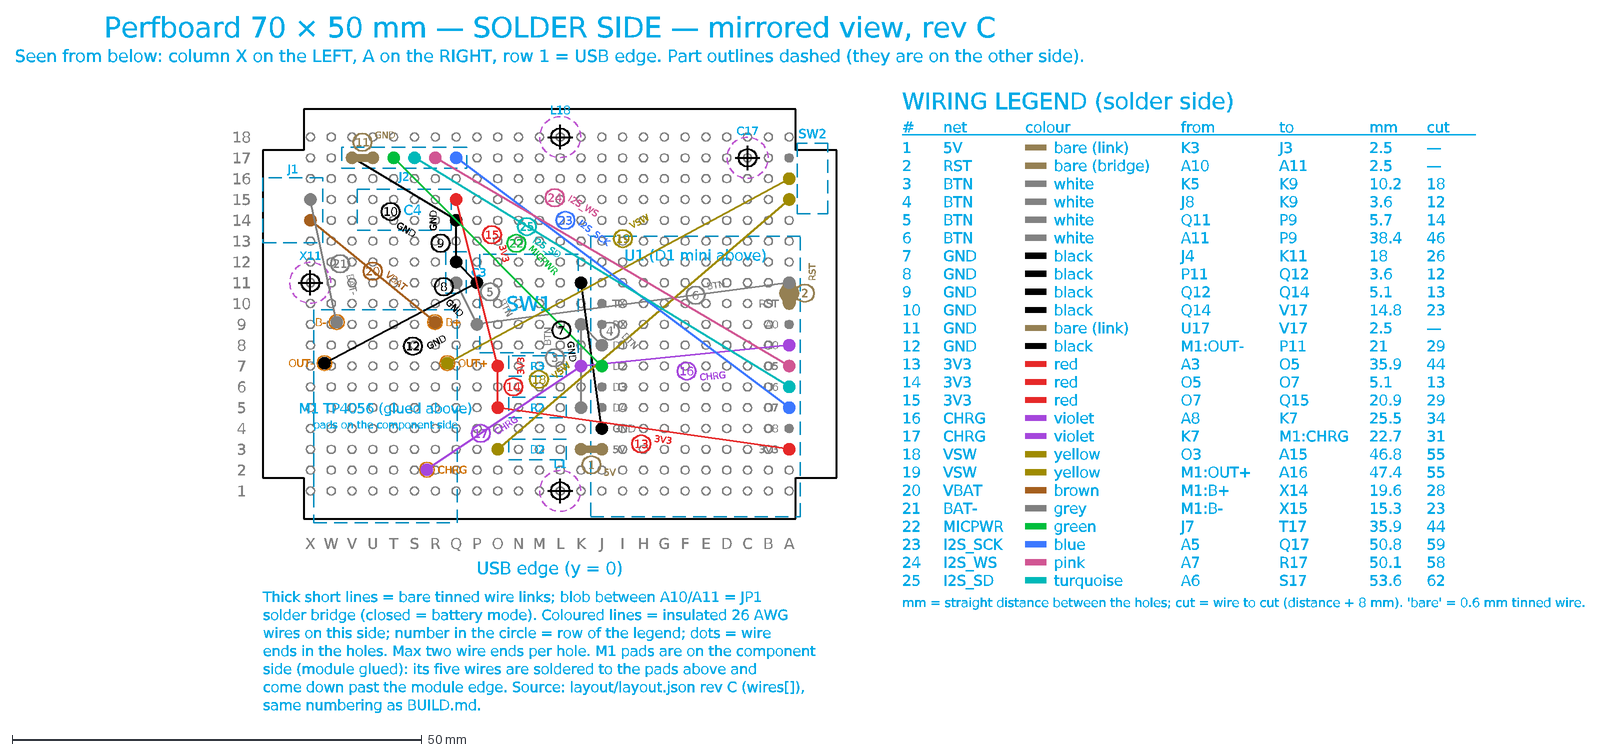
[picture p21: CAD file, 2026-10-26]
hardware/schematic/perfboard-solder-side.dxf
A
B
C
D
E
F
G
H
I
J
K
L
M
N
O
P
Q
R
S
T
U
V
W
X
1
2
3
4
5
6
7
8
9
10
11
12
13
14
15
16
17
18
L1
L18
C17
X11
U1 (D1 mini above)
SW1
D2
R2
R3
C3
C4
J2
J1
SW2
M1 TP4056 (glued above)
pads on the component side
3V3
D8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
