dnviti-personal-org/esp8266-d1mini-button/hardware/enclosure/lid.step

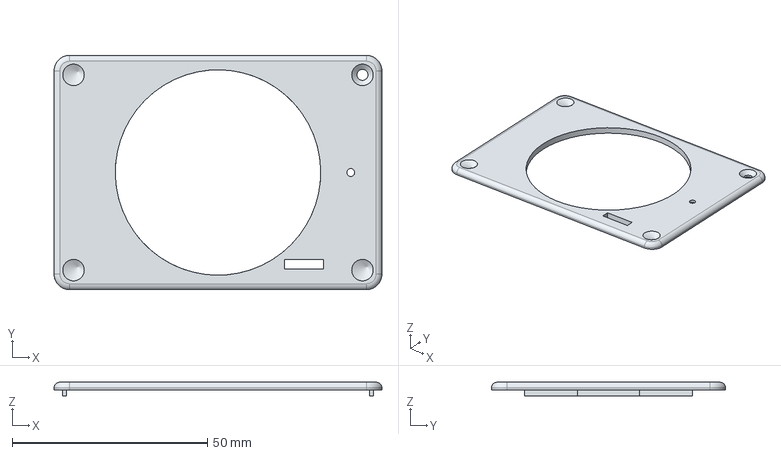
[picture p22: CAD file, 2026-10-26]
hardware/enclosure/lid.step
84.0 x 60.0 x 3.50 mm
