dnviti-personal-org/esp8266-d1mini-button/hardware/enclosure/plunger.step

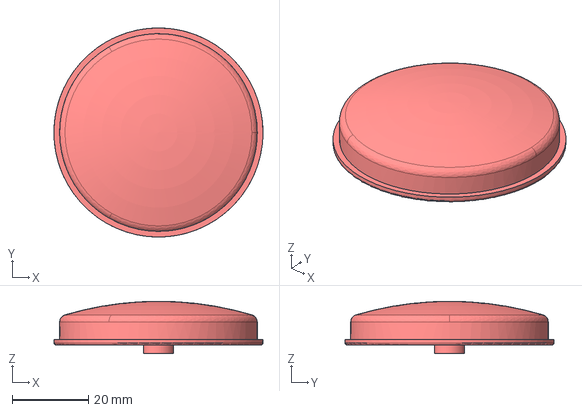
[picture p23: CAD file, 2026-10-26]
hardware/enclosure/plunger.step
55.0 x 55.0 x 13.8 mm
