dnviti-personal-org/esp8266-d1mini-button/(list of files, cad)

Other CAD files:
hardware/enclosure/assembly.stl
hardware/enclosure/base.stl
hardware/enclosure/electronics.stl
hardware/enclosure/full-assembly.stl
hardware/enclosure/lid.stl
hardware/enclosure/plunger.stl
