dnviti-personal-org/esp8266-d1mini-button/hardware/BUILD.md

# Build guide — perfboard assembly (rev C)

Everything in this guide is derived from `layout/layout.json`
(generated by `layout/gen_layout.py`); the drawings in `schematic/` and the 3D
model in `enclosure/` use the same hole names, so you only have to follow the
tables. **Hole names**: hold the perfboard with the **component side up** and
the edge that will carry the USB connectors **toward you**; columns run
**A → X from left to right**, rows **1 → 18 from near to far**. Mark A1 with a
pen before you start. When you turn the board over to solder, left and right
swap: the `perfboard-solder-side.svg` drawing is already mirrored for you.

Only through-hole parts are soldered; the three modules (D1 mini, TP4056
charger, INMP441 microphone) come pre-assembled.

## Tools and consumables

- Soldering iron (≤ 350 °C), 0.5–0.8 mm leaded or SAC solder, flux, cutters.
- Bare tinned wire 0.6 mm for the short links; insulated 26 AWG stranded
  hook-up wire in the colours of the table (any colours work, but keep one
  colour per net and write your substitutions in the table).
- 1 mm double-sided foam tape (for the charger module), kapton or PVC tape.
- Drill 2.2 mm (4 mounting holes), small file or cutters for the corner notches.
- Multimeter.

## 1. Prepare the board

1. Cut the four corners of the perfboard **5 × 5 mm** (they clear the lid screw bosses).
2. Drill the four **mounting holes** to Ø2.2 mm at the grid holes **L1, L18, C17, X11**.
   Nothing may be soldered on the 8 holes around each of them (the Ø5 mm
   standoff sits there).
3. With the USB edge toward you, mark **A1** (near-left) and **X18** (far-right).

## 2. Solder the components (component side), lowest first

| Step | Ref | Part | Leads in holes | Notes |
|---|---|---|---|---|
| 1 | D2 | 1N5819 Schottky, DO-41 | A → **O3**, K → **K3** | band (cathode) toward column K, next to U1's 5V pin |
| 2 | R2 | 10 kΩ 1/4 W | 1 → **K5**, 2 → **O5** | BTN pull-up |
| 3 | R3 | 10 kΩ 1/4 W | 1 → **K7**, 2 → **O7** | CHRG pull-up |
| 4 | C3 | 100 nF ceramic disc, 2.54 mm | 1 → **Q11**, 2 → **Q12** | any orientation |
| 5 | C4 | 100 µF 10 V electrolytic Ø5x11 | - → **Q14**, + → **Q15** | leads bent 90°, body lying flat toward column X; stripe (−) toward row 14 |
| 6 | J2 | 1x6 right-angle male header | SCK → **Q17**, WS → **R17**, SD → **S17**, VDD → **T17**, L/R → **U17**, GND → **V17** | bent pins point toward row 18 (board edge), plastic body on rows 17 |
| 7 | J1 | JST-PH 2-pin right-angle (S2B-PH-K-S) | 1 (+) → **X14**, 2 (−) → **X15** | opening toward the board edge (column X side); 2.0 mm pins spread to 2.54 mm |
| 8 | SW1 | tactile 12x12, 7.3 mm actuator (B3F-4000) | 1a → **K9**, 1b → **P9**, 2a → **K11**, 2b → **P11** | pins 12.5 mm apart go into holes 12.7 mm apart: spread them 0.1 mm each; pins on the same row are joined inside the switch |

## 3. Bare links and solder bridge (solder side)

| # | Net |  |  | mm |
|---|---|---|---|---|
| 1 | 5V | K3 | J3 | 2.5 |
| 2 | RST | A10 | A11 | 2.5 |
| 11 | GND | U17 | V17 | 2.5 |

## 4. Insulated wires (solder side)

Cut each wire to the **Cut** length (= straight distance + 8 mm), strip 3 mm
at both ends, tin, then solder each end into its hole **together with the lead
already there** (or alone where the hole is empty). Wires lie flat against the
solder side; they may cross each other and pass over other joints — they are
insulated. Do them in this order.

| # | Net | Colour | From | To | Length | Cut |
|---|---|---|---|---|---|---|
| 3 | BTN | white | K5 | K9 | 10.2 mm | 18 mm |
| 4 | BTN | white | J8 | K9 | 3.6 mm | 12 mm |
| 5 | BTN | white | Q11 | P9 | 5.7 mm | 14 mm |
| 6 | BTN | white | A11 | P9 | 38.4 mm | 46 mm |
| 7 | GND | black | J4 | K11 | 18.0 mm | 26 mm |
| 8 | GND | black | P11 | Q12 | 3.6 mm | 12 mm |
| 9 | GND | black | Q12 | Q14 | 5.1 mm | 13 mm |
| 10 | GND | black | Q14 | V17 | 14.8 mm | 23 mm |
| 12 | GND | black | M1:OUT- | P11 | 21.0 mm | 29 mm |
| 13 | 3V3 | red | A3 | O5 | 35.9 mm | 44 mm |
| 14 | 3V3 | red | O5 | O7 | 5.1 mm | 13 mm |
| 15 | 3V3 | red | O7 | Q15 | 20.9 mm | 29 mm |
| 16 | CHRG | violet | A8 | K7 | 25.5 mm | 34 mm |
| 17 | CHRG | violet | K7 | M1:CHRG | 22.7 mm | 31 mm |
| 18 | VSW | yellow | O3 | A15 | 46.8 mm | 55 mm |
| 19 | VSW | yellow | M1:OUT+ | A16 | 47.4 mm | 55 mm |
| 20 | VBAT | brown | M1:B+ | X14 | 19.6 mm | 28 mm |
| 21 | BAT- | grey | M1:B- | X15 | 15.3 mm | 23 mm |
| 22 | MICPWR | green | J7 | T17 | 35.9 mm | 44 mm |
| 23 | I2S_SCK | blue | A5 | Q17 | 50.8 mm | 59 mm |
| 24 | I2S_WS | pink | A7 | R17 | 50.1 mm | 58 mm |
| 25 | I2S_SD | turquoise | A6 | S17 | 53.6 mm | 62 mm |

## 5. Charger module M1

1. Stick 1 mm foam tape on the perfboard over columns **R..X, rows 1..9**
   (x 46.3–63.8 mm, y −0.5–25.5 mm from the A1 corner: the module overhangs
   the USB edge by 0.5 mm so its USB-C reaches the enclosure wall).
2. Press the TP4056 module on it, **USB-C toward the USB edge**, centred at
   **x = 55.0 mm** (= 1.1 mm right of column T).
3. Solder the five wires of table 4 that start with `M1:` to its pads:
   `B+`, `B−` (battery pads, far end), `OUT+`, `OUT−` (load pads), and `CHRG`
   = the pad of the charge LED that goes to TP4056 pin 7 (the LED pad
   **not** connected to the 5 V/resistor side; check with the multimeter in
   diode mode: pin 7 is the second pin from the USB-C on the side of the chip
   that faces the LEDs).  Leave `IN+`/`IN−` unused.

## 6. Power switch SW2

Bend the three pins of the SS12D00 90° at 1 mm from the body so the switch
lies on its side with the **lever pointing at the board edge** (left edge,
column A side) and the pins go down into **A15, A16, A17** (centre pin =
A16, the common). Solder; the body rests on the board, its lever will stick
out through the slot in the enclosure wall.

## 7. D1 mini U1

1. Put the two 8-pin male headers in the perfboard at **A3..A10** and
   **J3..J10** with the **LONG pins down** through the perfboard and the short
   pins up; the plastic spacer rests on the perfboard.
2. Seat the D1 mini on the short pins: **micro-USB toward the USB edge**,
   3V3 at A3 and 5V at J3 (RST at A10, TX at J10). Solder the 16 pins on top of
   the D1 mini.
3. Turn the board over, solder the 16 pins on the solder side (together with the
   wires of table 4 that land on A3..A10 / J3..J10) and **cut the long pins
   flush** — anything longer than 1 mm would touch the battery below.

## 8. Checks before powering

With the multimeter (no battery, no USB):
- `GND` (J4) to `3V3` (A3): > 10 kΩ, no short. `GND` to `5V` (J3): no short.
- `BTN` (K9) to `3V3`: ≈ 10 kΩ (R2). Press SW1: `BTN` to `GND` ≈ 0 Ω.
- `RST` (A10) to `BTN` (K9): 0 Ω if JP1 is bridged.
- `CHRG` (K7) to `3V3`: ≈ 10 kΩ (R3).
- J1 pin 1 (X14) to M1 `B+`: 0 Ω; J1 pin 2 (X15) to M1 `B−`: 0 Ω.
- SW2 ON: M1 `OUT+` to D2 anode (O3): 0 Ω; SW2 OFF: open.
Then plug the battery into J1 (red = +, toward row 14), switch SW2 on: the
D1 mini's LED blinks at boot; open the serial console (see README) and
configure Wi-Fi. Plug USB-C into M1 only to charge (red LED = charging,
blue = full).

## 9. Microphone lead

Make a 90 mm 6-wire lead with a female 1×6 DuPont housing on the J2 end:
J2 **SCK → M2 SCK**, **WS → WS**, **SD → SD**, **VDD → VDD**, **L/R → L/R**,
**GND → GND**. Solder the other ends to the INMP441 module pads; it goes in
the lid pocket, sound port over the Ø2 mm hole, component side toward the lid.
`L/R` is tied to GND (left channel) by the bare link U17–V17.
