dnviti-personal-org/esp8266-d1mini-button/hardware/enclosure/assembly-iso.png

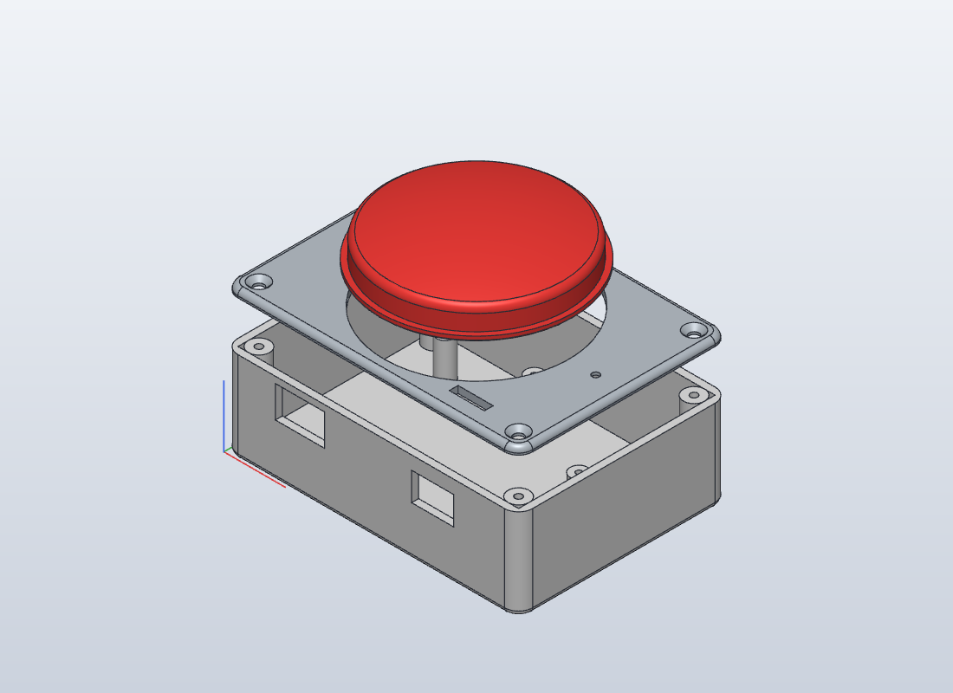
hardware/enclosure/assembly-iso.png
