dnviti-personal-org/esp8266-d1mini-button/hardware/schematic/perfboard-solder-side.png

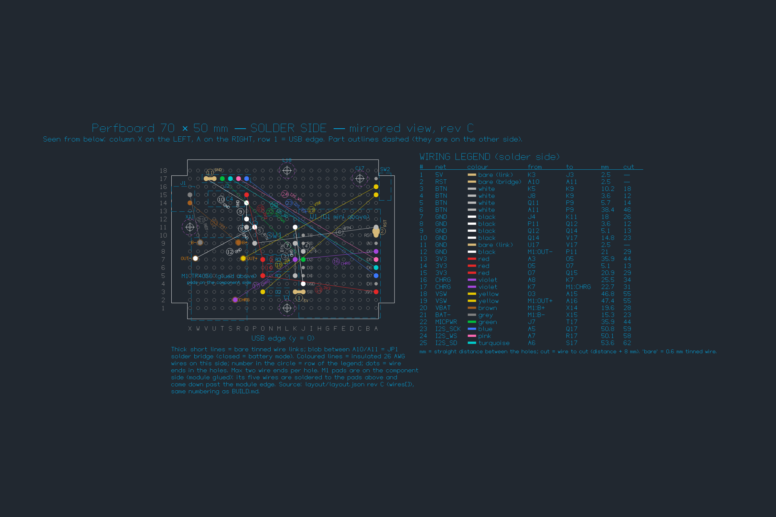
hardware/schematic/perfboard-solder-side.png
