dnviti-personal-org/esp8266-d1mini-button/hardware/schematic/perfboard-layout.pdf

×

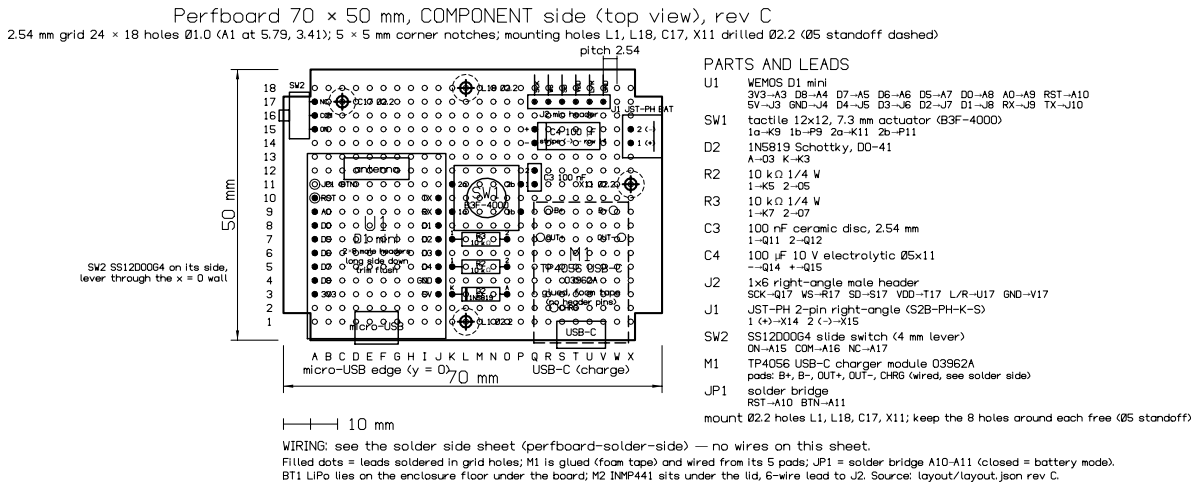
[picture p26: page 1]
