dnviti-personal-org/esp8266-d1mini-button/hardware/schematic/perfboard-solder-side.pdf

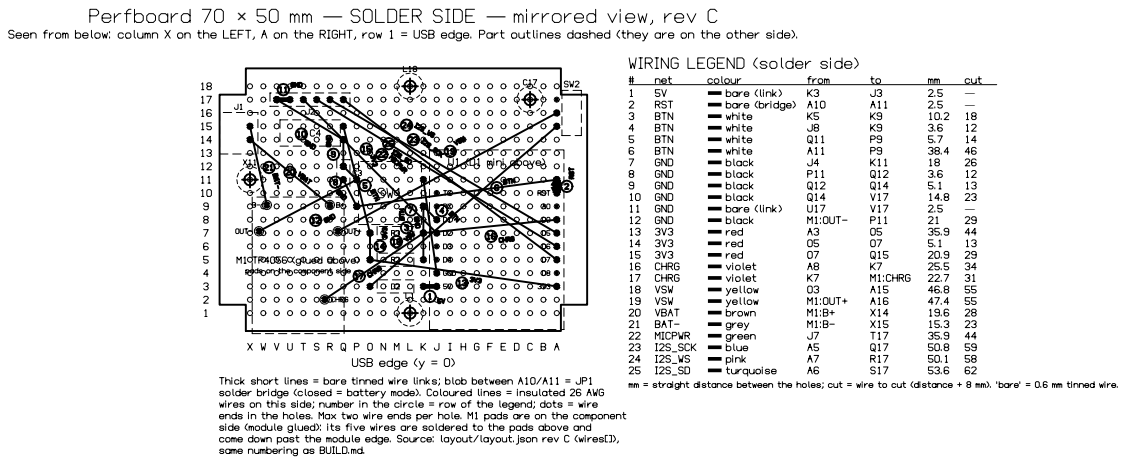
[picture p27: page 1]
