dnviti-personal-org/esp8266-d1mini-button/hardware/schematic/schematic.pdf

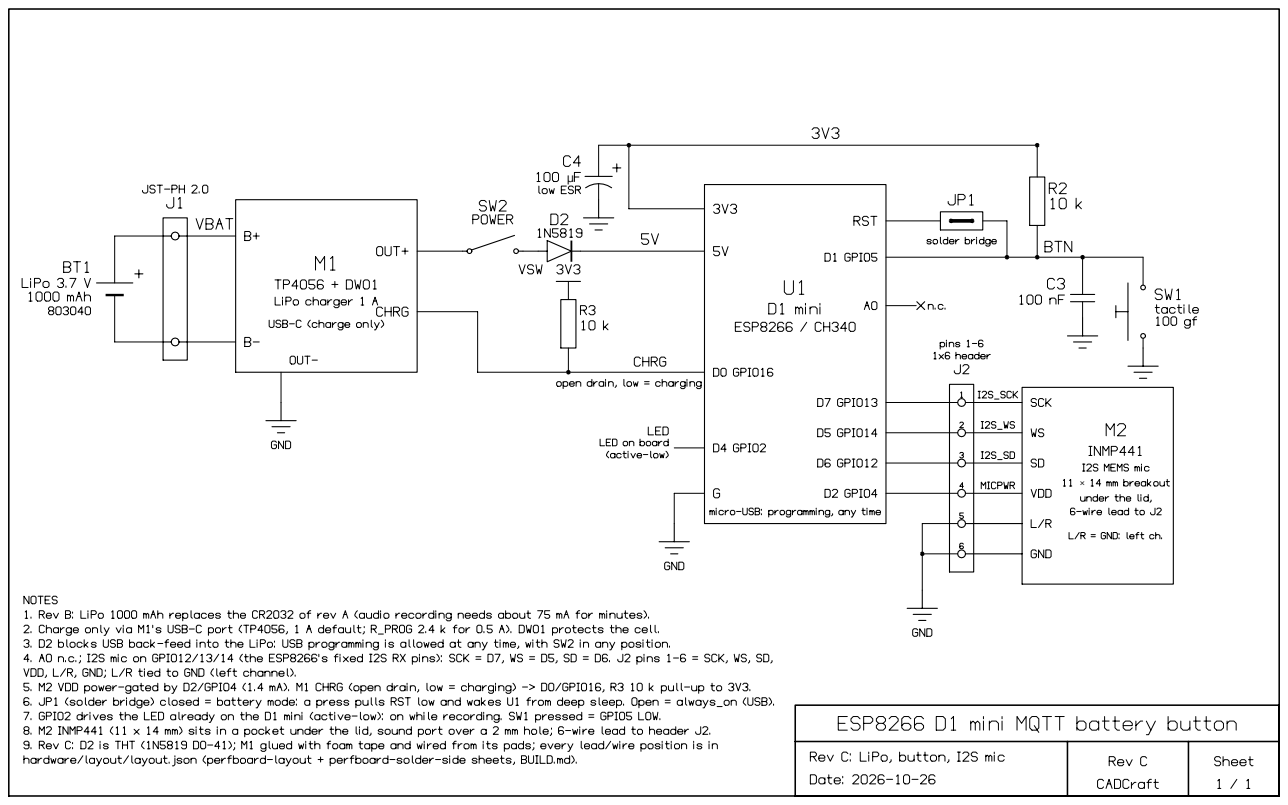
[picture p28: page 1]
