dnviti-personal-org/esp8266-d1mini-button/(commit log)

2026-10-26 docs: big key cap for elderly users, centred switch, 84x60 enclosure
2026-10-26 feat: firmware with serial config menu, MQTT + HA discovery, battery deep-sleep mode
    - src/logic: debouncer, command parser, settings with CRC32 (host-tested, 14 Unity tests)
    - EEPROM-backed settings editable from the serial console
    - Wi-Fi/MQTT state machine, HA discovery for binary_sensor + voltage sensor
    - battery mode: wake on RST, publish, deep sleep; RTC-cached fast reconnect
    - verified on hardware: menu, persistence, factory reset, sleep/wake cycle
2026-10-26 hardware: schematic, perfboard layout (CADCraft) and BOM
2026-10-26 hardware: 3D printable enclosure and key cap (SolidCraft scripts, STEP, STL, renders)
2026-10-26 docs: revision B — LiPo + TP4056 supply, MAX9814 microphone, audio recording
2026-10-26 feat: audio recording (INMP441 I2S mic, live WAV stream to Home Assistant), LiPo supply, rev B.1 hardware
    - AudioRecorder drains I2S DMA into a RAM ring (8 kHz 16-bit, digital gain)
    - AudioServer streams /rec.wav as a fixed-length WAV while recording
    - MQTT: recording JSON, recording_state and charging sensors, discovery
    - settings v3: record_seconds, mic_gain; serial: record/stop/scan
    - homeassistant/: downloader-based automations
    - hardware: LiPo + TP4056, schematic/layout/BOM rev B.1, enclosure with mic pocket,
    USB-C slot and LED window
    - verified on hardware with the real broker in both power modes
2026-10-26 docs: rev B.3 layout after full 3D assembly check (USB reach, corner notches, mounting holes, low-profile J2/JP1, taller cavity)
2026-10-26 docs: rev B.3 placement table and enclosure numbers
2026-10-26 hardware: rev B.3 — full 3D assembly with all electronics, clearance-driven layout fixes
    - electronics.* and full-assembly.* models (perfboard with notches and pins, D1 mini,
    TP4056, LiPo, switches, headers, discretes, INMP441), renders and clearance table
    - base/lid: standoffs and slots per rev B.3, 0 interferences
    - perfboard layout, schematic (JP1 solder bridge) and BOM updated
2026-10-26 hardware: rev C — grid-snapped perfboard layout, full wiring, realistic 3D models, build guide
    - hardware/layout/gen_layout.py -> layout.json: every lead on a named 2.54 mm hole (A..X x 1..18),
    25 wires with colour and cut length, automatic checks (hole conflicts, wire ends per hole,
    standoff clearance, body overlaps)
    - hardware/BUILD.md + BUILD.it.md: step-by-step assembly guide generated from the layout
    - schematic: component-side sheet and new mirrored solder-side wiring sheet, both from layout.json;
    schematic rev C (J2 pin order, JP1 bridge); BOM through-hole only, no SMD parts
    - enclosure: real STEP models (KiCad packages3D, Technariumas D1 mini) with sources and licences,
    all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
