dnviti-personal-org/esp8266-d1mini-button/(notices)

Notices in the files:
hardware/enclosure/models/SW_PUSH-12mm_Wuerth-430476085716.step:
Copyright (C) 2025, KiCAD
This work is licensed under the
[Creative Commons CC-BY-SA 4.0 License](https://creativecommons.org/licenses/by-sa/4.0/legalcode),
with the following exception:
project files under this or any other license agreement. However, if you wish to distribute
